thennen/rgo_keyboard_zmk_mod/pics/dimensions.pptx

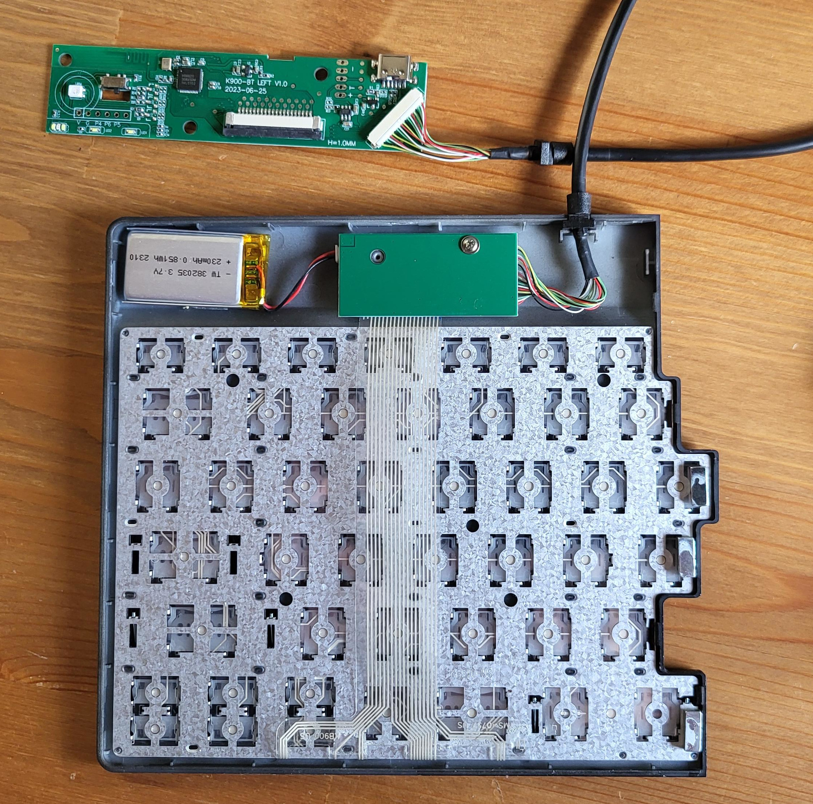
[picture p6: figure]
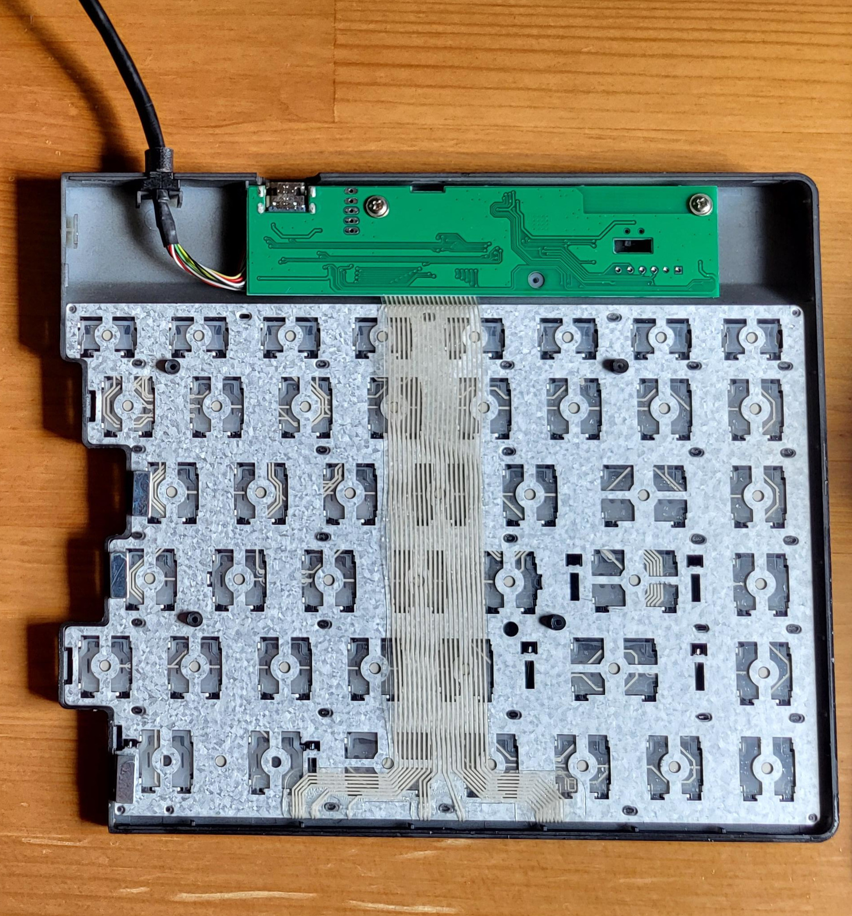
[picture p7: figure]

## Slide 2


## Slide 3


## Slide 4

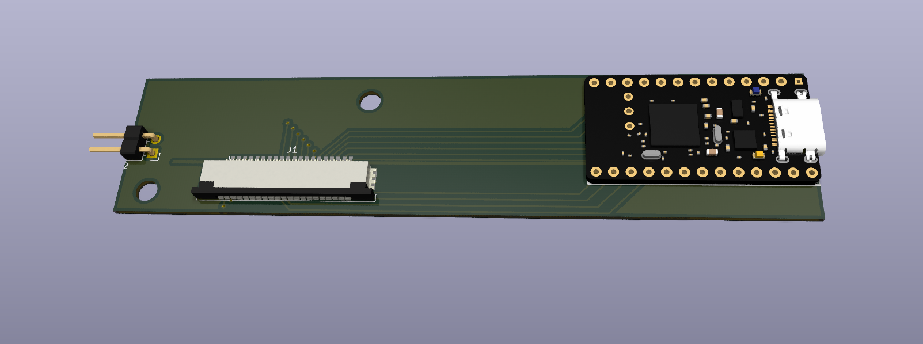
[picture p8: figure]
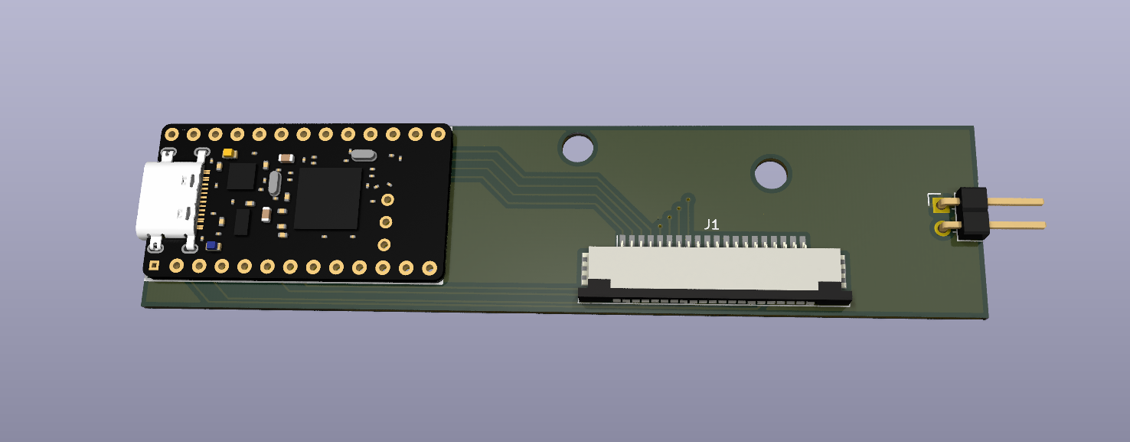
[picture p9: figure]
