thennen/rgo_keyboard_zmk_mod/pics/signal-2024-09-16-105716_006_0.jpeg

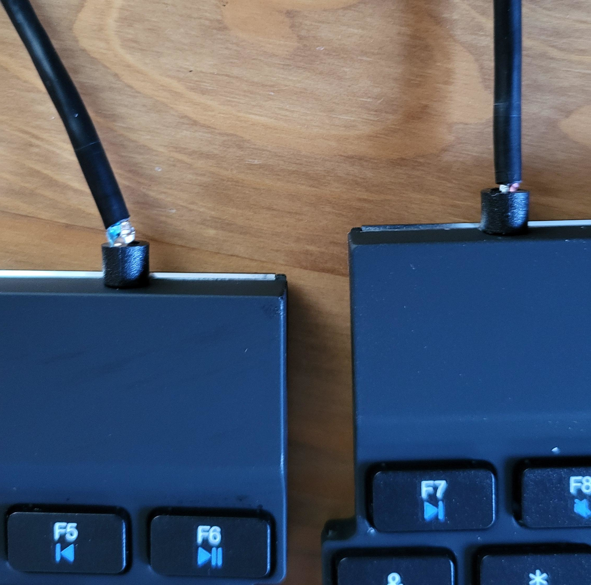
pics/signal-2024-09-16-105716_006_0.jpeg
