thennen/rgo_keyboard_zmk_mod/rgo_nice!nano/rgo_nice!nano_left.png

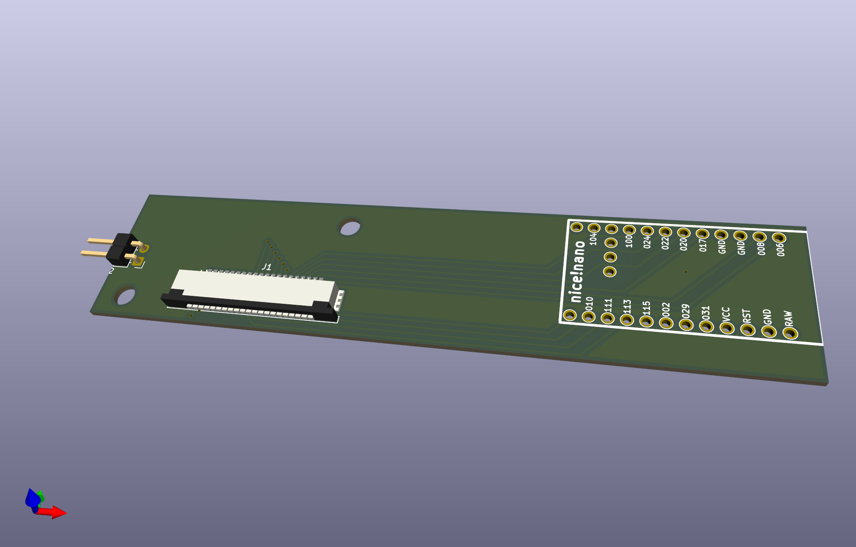
rgo_nice!nano/rgo_nice!nano_left.png
