thennen/rgo_keyboard_zmk_mod/rgo_nice!nano/rgo_nice!nano_right.png

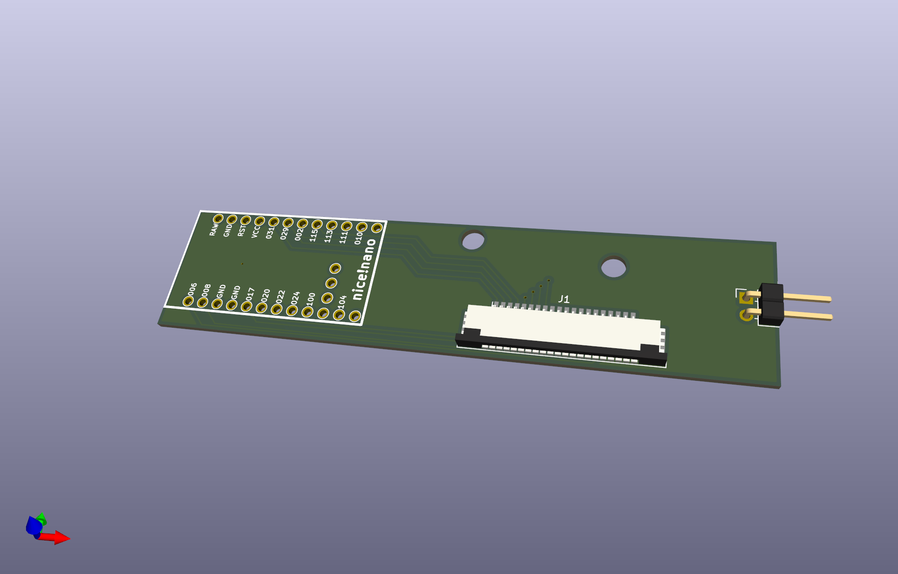
rgo_nice!nano/rgo_nice!nano_right.png
