thennen/rgo_keyboard_zmk_mod/rgo_nice!nano/rgo_nice!nano.kicad_pcb

## KiCad design rgo_nice!nano/rgo_nice!nano.kicad_pcb (2025-11-16)

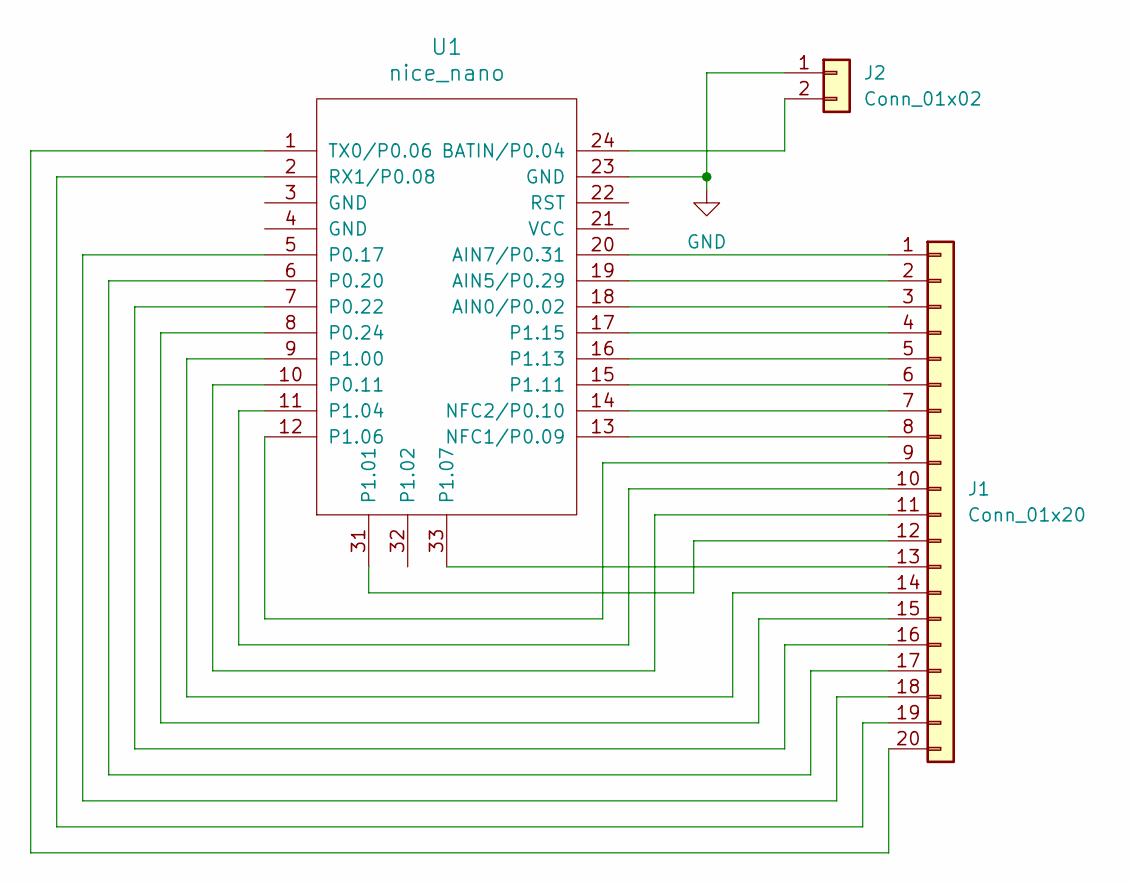
[picture p14: schematic rgo_nice!nano.kicad_sch, rgo keyboard wireless mod using nice!nano]

Parts:
J1: Conn_01x20; TE_2-84952-0_1x20-1MP_P1.0mm_Horizontal
J2: Conn_01x02; PinHeader_1x02_P2.54mm_Horizontal
U1: nice_nano

Connections:
GND: J2.1, U1.23 (GND)
unnamed: J1.1, U1.20 (AIN7/P0.31)
unnamed: J1.2, U1.19 (AIN5/P0.29)
unnamed: J1.3, U1.18 (AIN0/P0.02)
unnamed: J1.4, U1.17 (P1.15)
unnamed: J1.5, U1.16 (P1.13)
unnamed: J1.6, U1.15 (P1.11)
unnamed: J1.7, U1.14 (NFC2/P0.10)
unnamed: J1.8, U1.13 (NFC1/P0.09)
unnamed: J1.9, U1.12 (P1.06)
unnamed: J1.10, U1.11 (P1.04)
unnamed: J1.11, U1.10 (P0.11)
unnamed: J1.12, U1.31 (P1.01)
unnamed: J1.13, U1.33 (P1.07)
unnamed: J1.14, U1.9 (P1.00)
unnamed: J1.15, U1.8 (P0.24)
unnamed: J1.16, U1.7 (P0.22)
unnamed: J1.17, U1.6 (P0.20)
unnamed: J1.18, U1.5 (P0.17)
unnamed: J1.19, U1.2 (RX1/P0.08)
unnamed: J1.20, U1.1 (TX0/P0.06)
unnamed: J2.2, U1.24 (BATIN/P0.04)

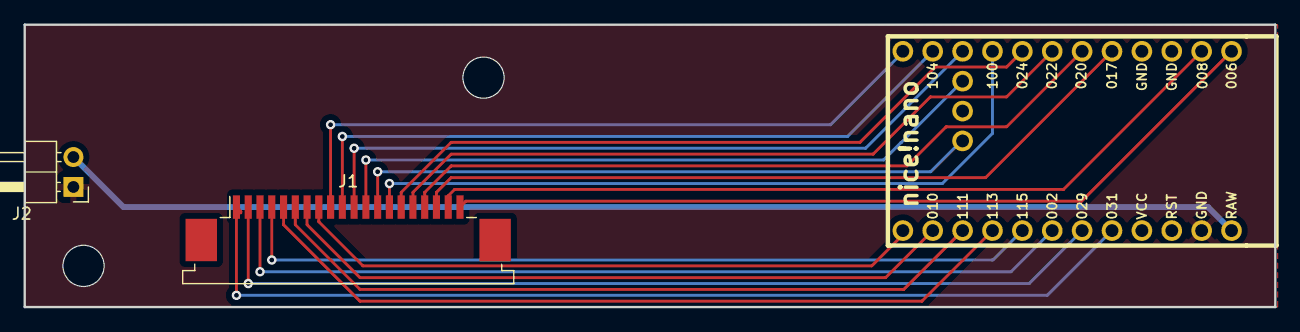
[picture p15: board rgo_nice!nano.kicad_pcb from above]

Board: 2 copper layers, 106.3 x 24.0 mm, 3 parts (0 on the bottom side), 22 nets.
