thennen/rgo_keyboard_zmk_mod/(commit log)

2025-11-16 first commit (late)
    [nice!nano v2.step, rgo_nice!nano.kicad_pcb, rgo_nice!nano.kicad_sch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]
2026-10-18 Add missing .gitmodules entry for nice-nano-kicad
    Fixes the 'git failed with exit code 128' warning in Actions checkout cleanup.
2026-10-18 Add record-and-play macro slots stored in flash
    New recmac/ Zephyr module with a behavior that records keystrokes at
    runtime, saves them via Zephyr settings, and plays them back. The six
    keys of the far-left column are slots: Fn+key records, key alone plays.
2026-10-18 Rewrite readme: explain the R-Go wireless mod, with photos
2026-10-18 Readme: trim stock photos, note known PCB mistakes
2026-10-18 notes edit, kicad 3d renders added
